stevensguille/heartmachine/pictures/in_use_bm_2010.jpg

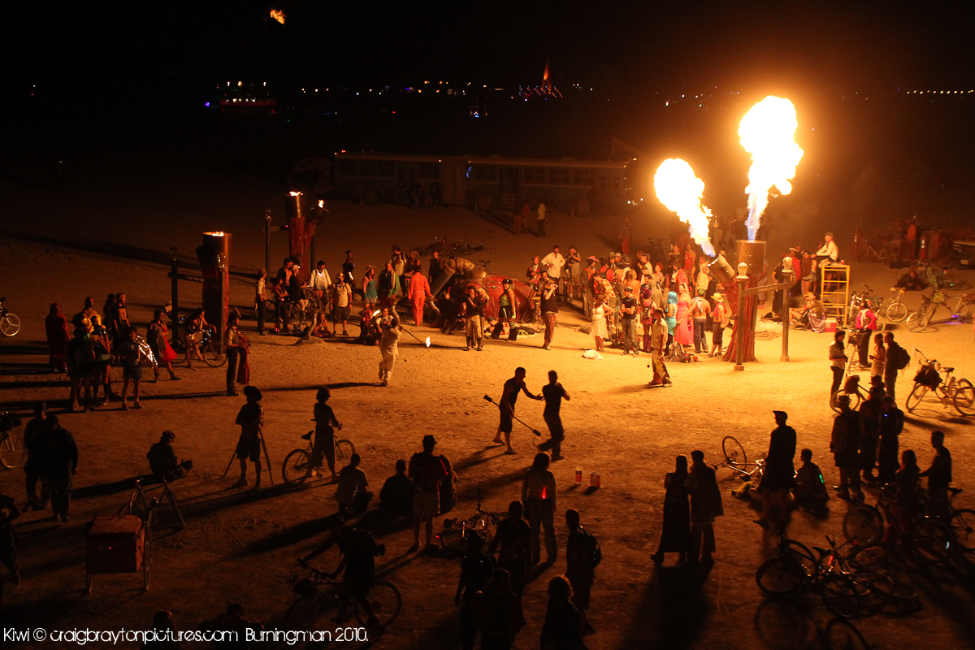
pictures/in_use_bm_2010.jpg
