stevensguille/heartmachine/pictures/2011nb20miles.jpg

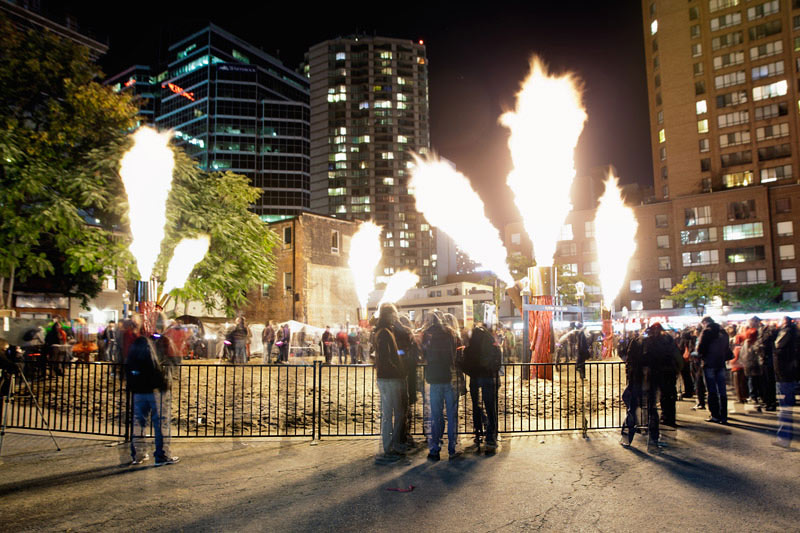
pictures/2011nb20miles.jpg
