stevensguille/heartmachine/docs/Dataflow.png

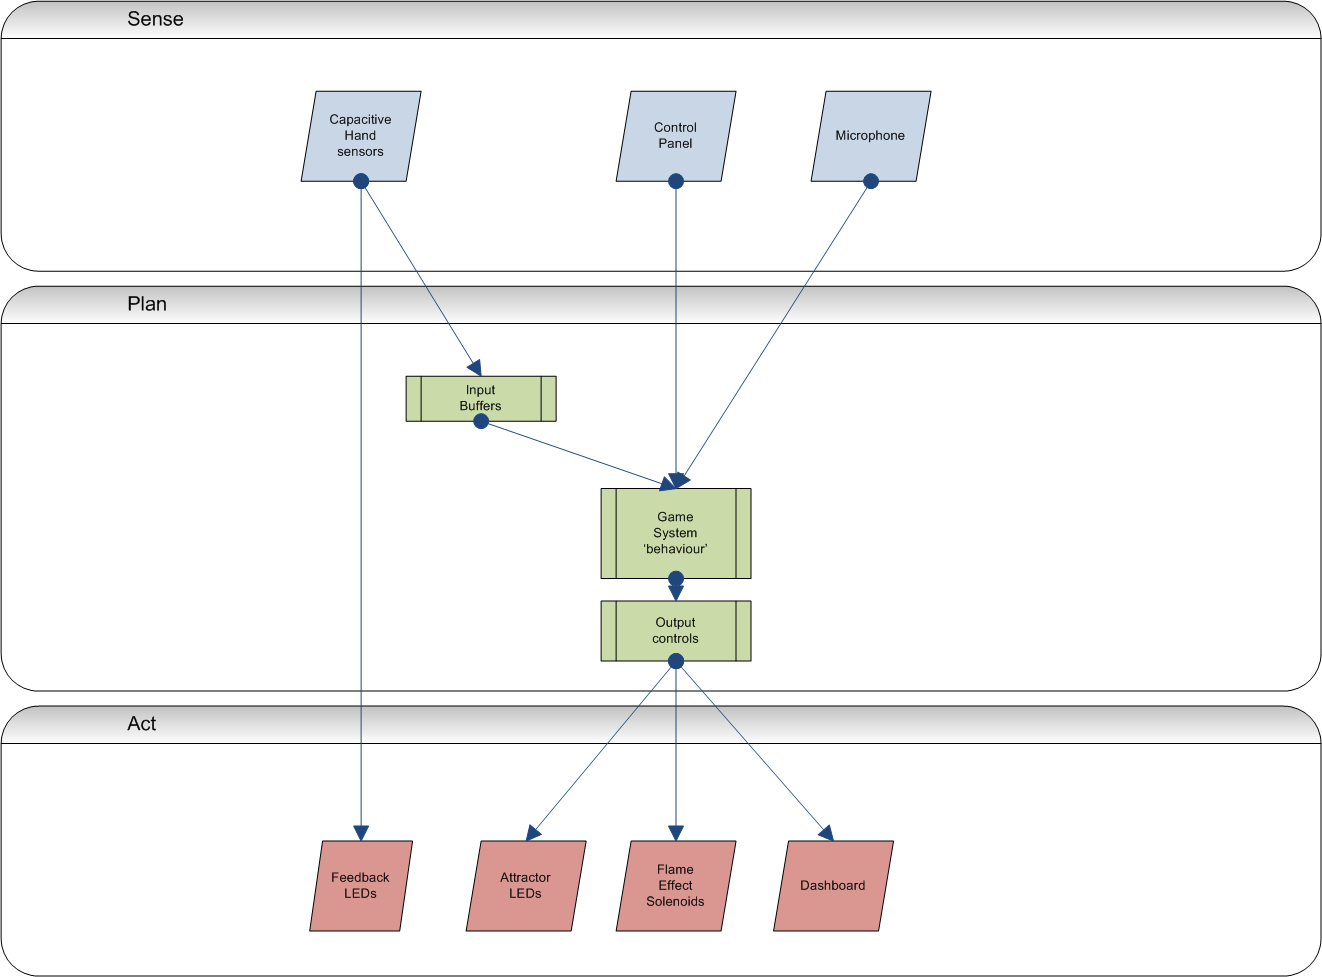
docs/Dataflow.png
