stevensguille/heartmachine/docs/heartmachinefront-2.png

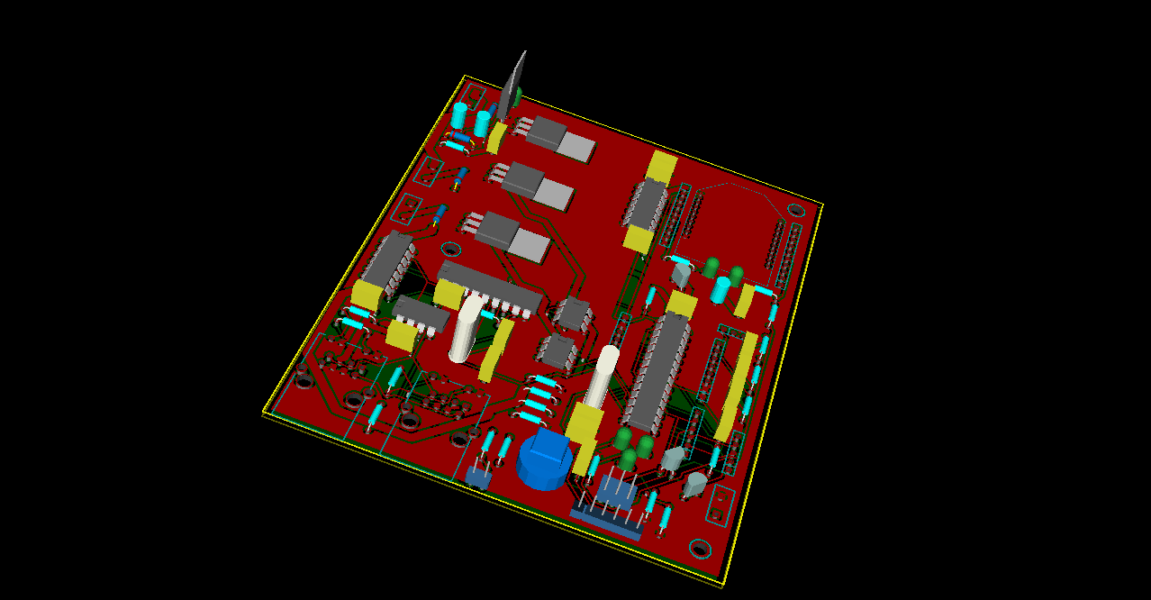
docs/heartmachinefront-2.png
