stevensguille/heartmachine/docs/overview.png

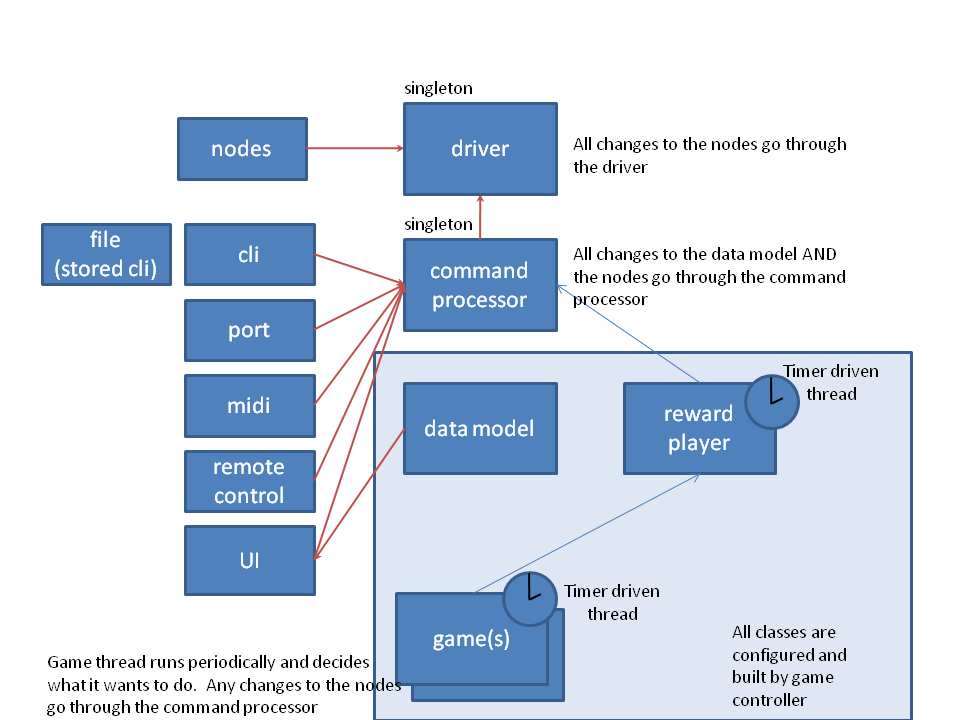
docs/overview.png
