stevensguille/heartmachine/pictures/flames.jpg

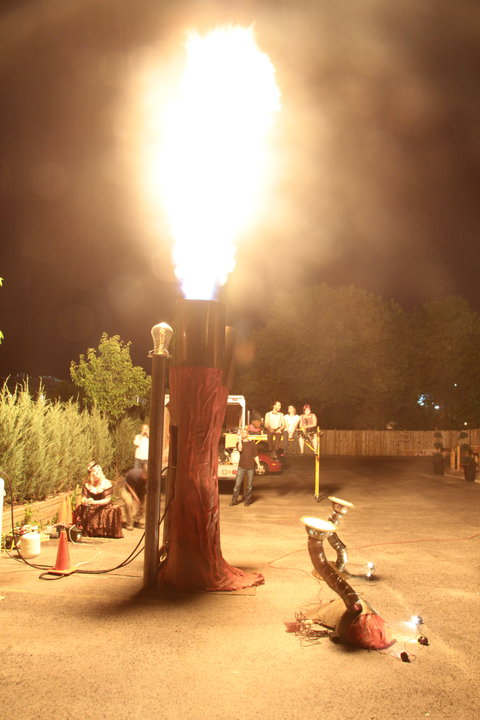
pictures/flames.jpg
