stevensguille/heartmachine/pictures/in_use_bm_2010_2.jpg

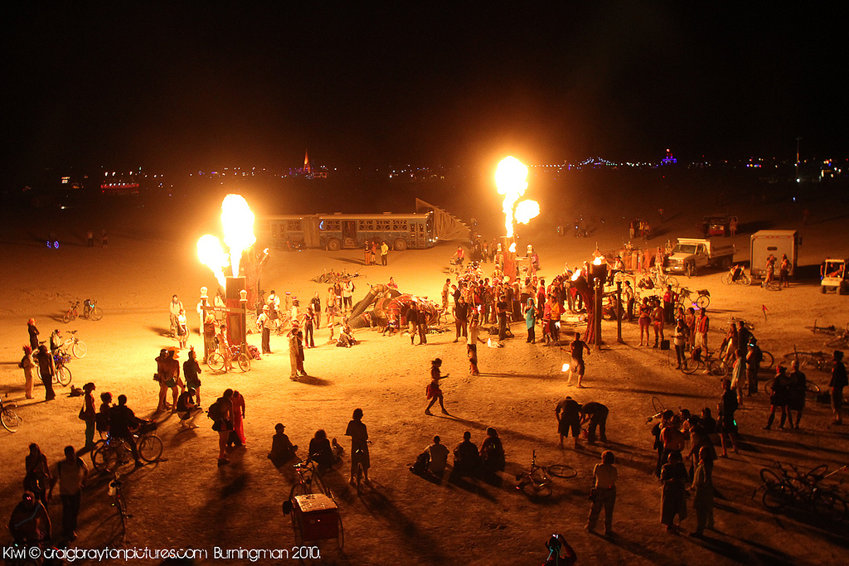
pictures/in_use_bm_2010_2.jpg
