stevensguille/heartmachine/pictures/thm-on-the-playa-smaller.jpg

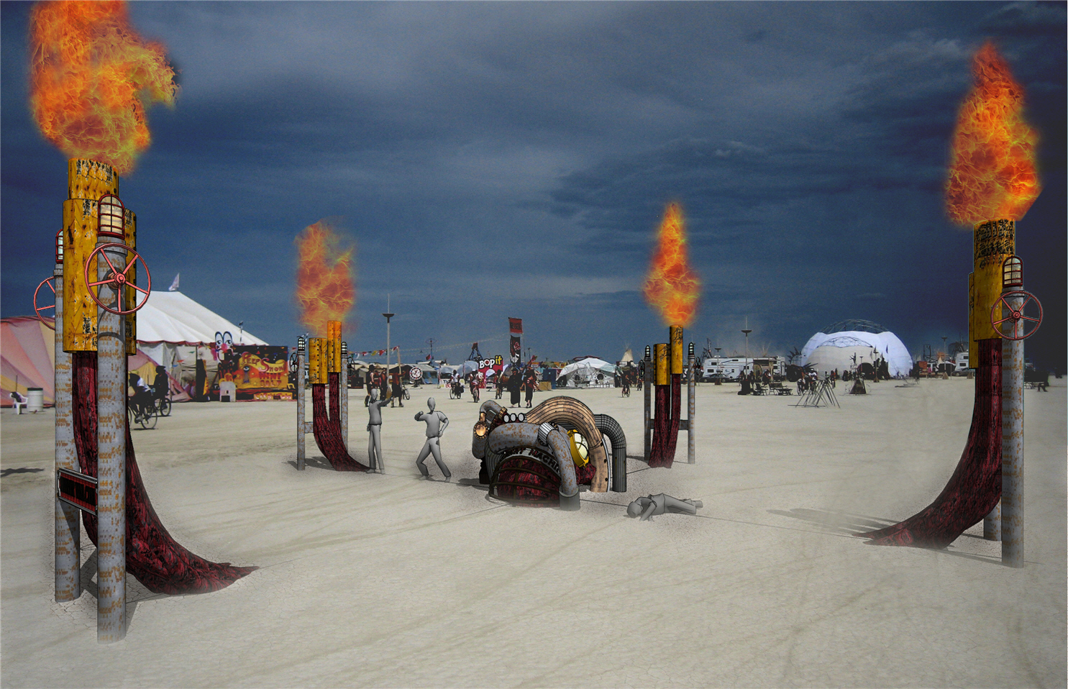
pictures/thm-on-the-playa-smaller.jpg
