stevensguille/heartmachine/mcp2515/thm_defines.h

/**
 *  thm_defines.h
 *
 *  Pin definitions for The Heart Machine node board.
 *
 *  Copyright (c) 2010 alexander kon-i ho <koniho ~BLAM~ gmail.com>
 */

#ifndef _THM_DEFINES_H_
#define _THM_DEFINES_H_

// TLC Pseudo Chip Select pin
#define CSTLC_PORT      PORTD
#define CSTLC_DDR       DDRD
#define CSTLC_PIN       PORTD7

// mcp2515 CAN Interface chip select
#define CSCAN_PORT      PORTD
#define CSCAN_DDR       DDRD
#define CSCAN_BIT       PORTD6

#endif
