stevensguille/heartmachine/mcp2515/attractor_patch.h

#ifndef _ATTRACTOR_PATCH_H_
#define _ATTRACTOR_PATCH_H_

#include "patches.h"

void attractor_init( void );
void attractor_enter( void );
void attractor_update( int16_t* deltas );
void attractor_exit( void );

extern thm_patch_t attractor_patch;
#endif 
