stevensguille/heartmachine/mcp2515/wipe_patch.h

#ifndef _WIPE_PATCH_H_
#define _WIPE_PATCH_H_

#include "patches.h"

void wipe_init( void );
void wipe_enter( void );
void wipe_update( int16_t* deltas );
void wipe_exit( void );

extern thm_patch_t wipe_patch;

#endif 
