stevensguille/heartmachine/thm/Tlc5940.h

/*  Copyright (c) 2009 by Alex Leone <acleone ~AT~ gmail.com>

    This file is part of the Arduino TLC5940 Library.

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
    You should have received a copy of the GNU General Public License
    along with The Arduino TLC5940 Library.  If not, see
    <http://www.gnu.org/licenses/>. */

#ifndef TLC5940_H
#define TLC5940_H

/** \file
    Tlc5940 library header file. */

#include <stdint.h>
#include "tlc_config.h"

#ifdef TLC_ATMEGA_8_H

/** Enables the Timer1 Overflow interrupt, which will fire after an XLAT
    pulse */
#define tlc_set_XLAT_interrupt()    TIFR |= _BV(TOV1); TIMSK = _BV(TOIE1)
/** Disables any Timer1 interrupts */
#define tlc_clear_XLAT_interrupt()  TIMSK = 0

#else

/** Enables the Timer1 Overflow interrupt, which will fire after an XLAT
    pulse */
#define tlc_set_XLAT_interrupt()    TIFR1 |= _BV(TOV1); TIMSK1 = _BV(TOIE1)
/** Disables any Timer1 interrupts */
#define tlc_clear_XLAT_interrupt()  TIMSK1 = 0

#endif

/** Enables the output of XLAT pulses */
#define tlc_enable_XLAT_pulses()    TCCR1A = _BV(COM1A1) | _BV(COM1B1)
/** Disables the output of XLAT pulses */
#define tlc_disable_XLAT_pulses()   TCCR1A = _BV(COM1B1)

extern volatile uint8_t tlc_needXLAT;
extern volatile void (*tlc_onUpdateFinished)(void);
extern uint8_t tlc_GSData_buf[NUM_TLCS * 24];
extern uint8_t* tlc_GSData;

/** The main Tlc5940 class for the entire library.  An instance of this class
    will be preinstantiated as Tlc. */
void tlc_init(uint16_t initialValue);
void tlc_clear(void);
uint8_t tlc_update(void);
void tlc_set(TLC_CHANNEL_TYPE channel, uint16_t value);
uint16_t tlc_get(TLC_CHANNEL_TYPE channel);
void tlc_setAll(uint16_t value);

void     tlc_setAll_buf(uint8_t* GSData, uint16_t value);
void     tlc_set_buf(uint8_t* GSData, TLC_CHANNEL_TYPE channel, uint16_t value);
uint16_t tlc_get_buf(uint8_t* GSData, TLC_CHANNEL_TYPE channel);


#if VPRG_ENABLED
    void tlc_setAllDC(uint8_t value);
#endif
#if XERR_ENABLED
    uint8_t tlc_readXERR(void);
#endif

void tlc_shift8_init(void);
void tlc_shift8(uint8_t byte);

#if VPRG_ENABLED
void tlc_dcModeStart(void);
void tlc_dcModeStop(void);
#endif

#endif
