stevensguille/heartmachine/thm/flame_cpatch.h

/*
 * flame_cpatch.h
 */

#ifndef flame_PATCH_H_
#define flame_PATCH_H_

#include "patches.h"

void flame_init( void );
void flame_enter( void );
void flame_update( int16_t* deltas );
void flame_activate( int16_t* params );
void flame_deactivate( void );
void flame_exit( void );

extern thm_cpatch_t flame_patch;

#define SOLENOID_ONE_ONLY 	0
#define SOLENOID_TWO_ONLY 	1
#define SOLENOID_BOTH 		2


#define MAX_SOLENOID_DURATION	300

#endif /* SOLENOID_PATCH_H_ */
