stevensguille/heartmachine/thm/heartbeat_cpatch.h

/*
 * heartbeat_patch.h
 *
 */

#ifndef HEARTBEAT_CPATCH_H_
#define HEARTBEAT_CPATCH_H_

#include "patches.h"

void heartbeat_init( void );
void heartbeat_enter( void );
void heartbeat_update( int16_t* deltas );
void heartbeat_activate( int16_t* activate );
void heartbeat_deactivate( void );
void heartbeat_exit( void );

extern thm_cpatch_t heartbeat_patch;

#endif /* SOLENOID_PATCH_H_ */
