stevensguille/heartmachine/thm/patch_id.h

/**
 *  All patch ID's are Defined HERE NOWHERE ELSE OR IT WILL GET
 *  SO CONFUSING THAT VOMIT WILL APPEAR.
 */
#ifndef _PATCH_ID_H_
#define _PATCH_ID_H_

// visual patches
#define PATCH_ID_NULL                '0'
#define PATCH_ID_SINE                's'
#define PATCH_ID_PULSE               'p'
#define PATCH_ID_VECTOR              'v'

// control patches
#define CPATCH_ID_NULL               '0'
#define CPATCH_ID_SOLENOID           's'
#define CPATCH_ID_HEARTBEAT          'h'
#define CPATCH_ID_FLAME              'f'

#endif
