stevensguille/heartmachine/thm/simple_solenoid_cpatch.h

/*
 * simple_solenoid_patch.h
 *
 *  Created on: Aug 4, 2010
 *      Author: max
 */

#ifndef SIMPLE_SOLENOID_PATCH_H_
#define SIMPLE_SOLENOID_PATCH_H_

#include "patches.h"

void simple_solenoid_init( void );
void simple_solenoid_enter( void );
void simple_solenoid_update( int16_t* deltas );
void simple_solenoid_activate( int16_t* activate );
void simple_solenoid_deactivate( void );
void simple_solenoid_exit( void );

extern thm_cpatch_t simple_solenoid_patch;

#endif /* SOLENOID_PATCH_H_ */
